BearXP/ESP32_WiFi/PowerSupplyDesign/Calcs/Transformerless_HalfWaverRectifier.xlsx

Design |  | Power | Minimum possible Iin - For application
Vrms | 115 |  | VHRMS | 75.23174593
Vzener | 5.1 | 0.217W |  |  | VRms | 110
f | 60 |  |  |  | Vz | 5.1
C | 4.7e-07 | Use X2class | Xc1 | 7114.023918
R1 | 470 | 0.23W |  |  | C1 | 3.76e-07
 |  | 0.47W |  |  | f | 59.5
Vdiode | 0.6 |  | R1 | 517
 |  |  | Iin | 0.009858669916 | 0.009858669916
Vout | 4.5 |  | Iout | 0.009858669916
 |  |  | Maximum possible Iin - Power requirements for parts
 |  |  | VHRMS | 82.35281374
 |  |  |  |  | VRms | 120
 |  |  |  |  | Vz | 5
 |  |  | Xc1 | 4695.334699
 |  |  |  |  | C1 | 5.64e-07
 |  |  |  |  | f | 60.1
 |  |  | R1 | 423
 |  |  | Iin | 0.0160897672 | 0.0160897672
 |  |  | Iout | <=0.01609
http://ww1.microchip.com/downloads/en/AppNotes/00954A.pdf
