BearXP/ESP32_WiFi/BOM.xlsx

CapBridge7803_240V
ID | Ref | Description | Qty | Cost/ea | MOQ | Cost total | Link
1 | C1, C3 | CAP 1u X2 | 2 | $0.28 | 10 | $0.57 | 1uF (https://www.aliexpress.com/item/F011-1-1uF-10pcs-capacitor-X2-capacitor-275VAC-Pitch-22mm-X2-Polypropylene-film-capacitor-1uF/32714339342.html)
2 | D1,D2,D3,D4 | Bridge rectifier | 1 | $0.06 | 10 |  | Bridge (https://www.aliexpress.com/item/20pcs-MB10F-MB10-SOP4-1A-1000V-SMD-ultra-thin-bridge-rectifier-bridge-pile-high-quality/32553323900.html)
2.1 | D1,D2,D3,D4 | Bridge rectifier | 1 | $0.03 | 100 | $0.03 | 100 Bridge (https://www.aliexpress.com/item/100pcs-MB10F-MB10-SOP4-1A-1000V-SMD-ultra-thin-bridge-rectifier-bridge-pile-high-quality/32553068350.html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)
3 | D5 | Zener 6V2 1W | 1 | $0.05 | 50 | $0.05 | Zener (https://www.aliexpress.com/item/Free-shipping-10pcs-ZM4735A-1W-6-2V-LL41-6V2-Zener-diode/32379898135.html)
4 | C2, C4 | Cap 470u 16V | 2 | $0.05 | 20 | $0.11 | 470u (https://www.aliexpress.com/item/1LOT-20PCS-Aluminum-Capacitors-470uF-477-20-8-14mm-25V-470000nF-470000000pF-Diameter8mm/32709807005.html)
5 | U1 | Reg 3v3 | 1 | $0.03 | 100 | $0.03 | 3V3 (https://www.aliexpress.com/item/Free-Shipping-100PCS-LOT-Original-AMS1117-3-3-AMS1117-3-3V-AMS1117-LM1117-1117-Voltage-Regulator/32517690677.html)
6 | F1 | Polyfuse 0.5A 1206 | 1 | $0.05 | 50 |  | Polyfuse (https://www.aliexpress.com/item/50PCS-1206-0-5A-0-5-Amp-500mA-PolySwitch-SMT-SMD-Resettable-Fuse/32705064645.html)
6 | F1 | Fuse 0.5A 1206 | 1 | $0.04 | 50 | $0.04 | Fuse (https://www.aliexpress.com/item/50PCS-Lot-1206-0-5A-2A-0-1A-0-2A-0-5A-0-75A-1-1A/32812178091.html)
7 | V1 | Varistor | 1 | $0.07 | 100 | $0.07 | Varistor (https://www.aliexpress.com/item/50pcs-lot-Varistor-Resistor-Voltage-Dependent-Resistor-14D561K-14D-561K/32460788025.html)
8 | R3 | Res 47R | 1 | $0.01 | 100 | $0.01 | 47R (https://www.aliexpress.com/item/Free-shipping-50pcs-1-ohm-1-2W-Metal-film-resistor/32328677208.html)
 |  |  |  |  |  | $0.91
Integrated Rectifier - Replaces Diodes - Fixed 5V out
ID | Ref | Description | Qty | Cost/ea | MOQ | Cost total | Link
1 | U1 | Rectifier 5V 2W | 1 | 3.275 | 10 | 3.275 | Rectifier (https://www.aliexpress.com/item/1pcs-2016-new-small-size-ac-dc-power-supply-220v-to-5v-2w-intelligent-household-isolated/32709066044.html)
2 | F1 | Fuse 0.5A 1206 | 1 | $0.04 | 50 | $0.04 | Fuse (https://www.aliexpress.com/item/50PCS-Lot-1206-0-5A-2A-0-1A-0-2A-0-5A-0-75A-1-1A/32812178091.html)
3 | V1 | Varistor | 1 | $0.07 | 100 | $0.07 | Varistor (https://www.aliexpress.com/item/50pcs-lot-Varistor-Resistor-Voltage-Dependent-Resistor-14D561K-14D-561K/32460788025.html)
4 | C2, C4 | Cap 470u 16V | 2 | $0.05 | 20 | $0.11 | 470U (https://www.aliexpress.com/item/1LOT-20PCS-Aluminum-Capacitors-470uF-477-20-8-14mm-25V-470000nF-470000000pF-Diameter8mm/32709807005.html)
5 | D5 | Zener 6V2 1W | 1 | $0.05 | 50 | $0.05 | Zener (https://www.aliexpress.com/item/Free-shipping-10pcs-ZM4735A-1W-6-2V-LL41-6V2-Zener-diode/32379898135.html)
6 | C1, C3 | CAP 1u X2 | 2 | $0.28 | 10 | $0.57 | 1uF (https://www.aliexpress.com/item/F011-1-1uF-10pcs-capacitor-X2-capacitor-275VAC-Pitch-22mm-X2-Polypropylene-film-capacitor-1uF/32714339342.html)
 |  |  |  |  |  | $4.11
Transformer - Replaces C1, C3, R1, & R3
ID | Ref | Description | Qty | Cost/ea | MOQ | Cost total | Link
1 | U1 | Transformer 12V 5W | 1 | 23.46 | 1 |  | Transformer (https://www.aliexpress.com/item/5W-double-12V-5W2-12V-transformer-power-transformer-Input-220V-50Hz-Output-Double-12v/32356521490.html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)
1.1 | Ua | Transformer 6V 5VA | 1 | $6.84 | 1 | 6.84 | RS Transformer (http://au.rs-online.com/web/p/pcb-transformers/1739923/)
2 | D1,D2,D3,D4 | Bridge rectifier | 1 | $0.06 | 10 |  | Bridge (https://www.aliexpress.com/item/20pcs-MB10F-MB10-SOP4-1A-1000V-SMD-ultra-thin-bridge-rectifier-bridge-pile-high-quality/32553323900.html)
2.1 | D1,D2,D3,D4 | Bridge rectifier | 1 | $0.03 | 100 | $0.03 | 100 Bridge (https://www.aliexpress.com/item/100pcs-MB10F-MB10-SOP4-1A-1000V-SMD-ultra-thin-bridge-rectifier-bridge-pile-high-quality/32553068350.html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)
3 | D5 | Zener 6V2 1W | 1 | $0.05 | 50 | $0.05 | Zener (https://www.aliexpress.com/item/Free-shipping-10pcs-ZM4735A-1W-6-2V-LL41-6V2-Zener-diode/32379898135.html)
4 | C2, C4 | Cap 470u 16V | 2 | $0.05 | 20 | $0.11 | 470U (https://www.aliexpress.com/item/1LOT-20PCS-Aluminum-Capacitors-470uF-477-20-8-14mm-25V-470000nF-470000000pF-Diameter8mm/32709807005.html)
5 | U1 | Reg 3v3 | 1 | $0.03 | 100 | $0.03 | 3V3 (https://www.aliexpress.com/item/Free-Shipping-100PCS-LOT-Original-AMS1117-3-3-AMS1117-3-3V-AMS1117-LM1117-1117-Voltage-Regulator/32517690677.html)
6 | F1 | Polyfuse 0.5A 1206 | 1 | $0.05 | 50 |  | Polyfuse (https://www.aliexpress.com/item/50PCS-1206-0-5A-0-5-Amp-500mA-PolySwitch-SMT-SMD-Resettable-Fuse/32705064645.html)
6 | F1 | Fuse 0.5A 1206 | 1 | $0.04 | 50 | $0.04 | Fuse (https://www.aliexpress.com/item/50PCS-Lot-1206-0-5A-2A-0-1A-0-2A-0-5A-0-75A-1-1A/32812178091.html)
7 | V1 | Varistor | 1 | $0.07 | 100 | $0.07 | Varistor (https://www.aliexpress.com/item/50pcs-lot-Varistor-Resistor-Voltage-Dependent-Resistor-14D561K-14D-561K/32460788025.html)
 |  |  |  |  |  | $7.17
