BearXP/ESP32_WiFi/PowerSupplyDesign/LTSpice/BridgeNPN_NMOS_7805.asc

C1: cap; 22p
C2: cap; 470µF; V=16V
C3: cap; 470µF; V=16V
D1: diode; RRE02VS6S
D2: diode; RRE02VS6S
D3: diode; RRE02VS6S
D4: diode; RRE02VS6S
D5: diode
M1: nmos
Q1: npn
R1: res; 4.7
R2: res; 220K; pwr=1
R3: res; 10K
R4: res; 47k; pwr=0.5W
R5: res; 1k
U1: LT1083-5
V1: voltage; SINE(0 338.4 50)
Named nets: 0
.tran 10s
