BearXP/ESP32_WiFi/PowerSupplyDesign/LTSpice/CapBridge7813.asc

C1: cap; 1µ; V=600V
C2: cap; 470µ; V=16V
C3: cap; 1µ; V=600V
C4: cap; 470µ; V=16V
D1: diode; RR2L6S
D2: diode; RR2L6S
D3: diode; RR2L6S
D4: diode; RR2L6S
D5: zener; BZX84C6V2L
R1: res; 470k; pwr=1
R2: res; 33R
R3: res; 47R
U1: LT1084-3.3
V1: voltage; SINE(0 340 50)
Named nets: 0
.tran 0.2s
