BearXP/ESP32_WiFi/PowerSupplyDesign/LTSpice/Draft1.asc

C1: cap; 2µ2; V=400
C2: cap; 470µ; V=16
D1: diode
D2: diode
D3: diode
D4: diode
D5: zener; BZX84C15L
D6: LED
R1: res; 470k; pwr=1
R2: res; 100R; pwr=1
R3: res; 220R; pwr=1
R4: res; 1k
V1: voltage; SINE(0 230 50)
Named nets: 0
.tran 0.5s
