BearXP/ESP32_WiFi/PowerSupplyDesign/LTSpice/Draft4.asc

C1: cap; 470µ
C2: cap; 470µ
C3: cap; 200p
D1: zener; BZX84C6V2L
D2: diode
M1: nmos; R6020PNJ
M2: nmos; R6020PNJ
R1: res; 10k
R2: res; 10k
R3: res; 50R
R4: res; 330k
V1: voltage; SINE(0 310 50)
Named nets: 0
.tran 100m
