BearXP/ESP32_WiFi/LightSwitch.brd

## EAGLE design LightSwitch.brd (2017-09-10)

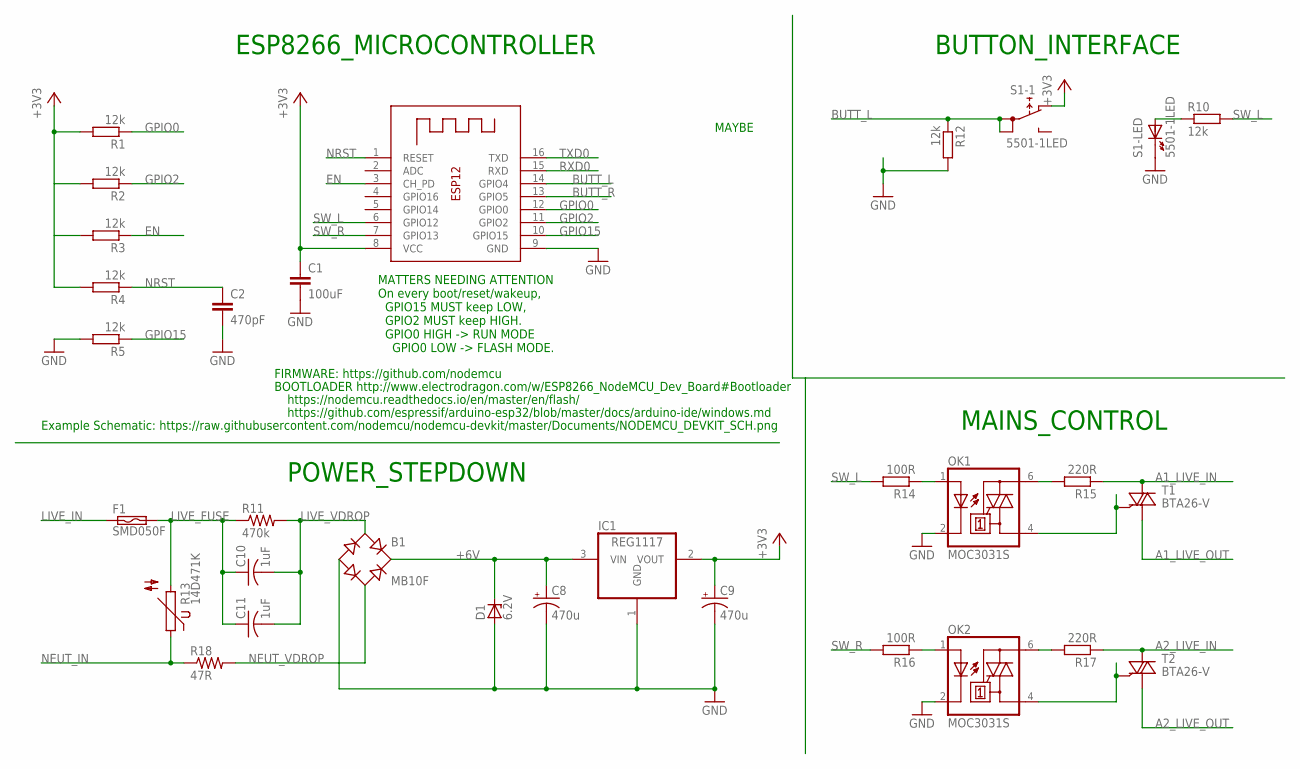
[picture p1: schematic LightSwitch.sch]

Parts:
B1: MB10F; SOIC-4
C1: 100uF; C0805K
C2: 470pF; C0805K
C8, C9: 470u; E3,5-8
C10, C11: 1uF; C225-074X268
D1: 6.2V; SMB
F1: SMD050F
IC1: REG1117; SOT223
OK1, OK2: MOC3031S; DIL6-SMD
R1, R2, R3, R4, R5, R10, R12: 12k; M0805
R11: 470k; 0309/12
R13: 14D471K; S07K40
R14, R16: 100R; M0805
R15, R17: 220R; M0805
R18: 47R; 0309/12
S1: 5501-1LED
T1, T2: BTA26-V; TOP3S-1
X1: ESP-12

Connections:
+3V1: R2.2
+3V2: R3.2
+3V3: C1.1, C9.+, IC1.2 (VOUT), R1.2, R4.2, S1.NC, X1.8 (VCC)
+6V: B1.+, C8.+, D1.C, IC1.3 (VIN)
A1_LIVE_IN: R15.1, T1.A2
A1_LIVE_OUT: T1.A1
A2_LIVE_IN: R17.1, T2.A2
A2_LIVE_OUT: T2.A1
BUTT_L: R12.1, S1.1A, S1.1B, X1.14 (GPIO4)
BUTT_R: X1.13 (GPIO5)
EN: R3.1, X1.3 (CH_PD)
GND: B1.-, C1.2, C2.2, C8.-, C9.-, D1.A, IC1.1 (GND), OK1.2 (C), OK2.2 (C), R5.2, R12.2, S1.- (K), X1.9 (GND)
GPIO0: R1.1, X1.12 (GPIO0)
GPIO2: R2.1, X1.11 (GPIO2)
GPIO15: R5.1, X1.10 (GPIO15)
LIVE_FUSE: C10.1, C11.1, F1.2, R11.1, R13.2
LIVE_IN: F1.1
LIVE_VDROP: B1.~1 (AC1), C10.2, C11.2, R11.2
unnamed: R10.1, S1.+ (A)
unnamed: OK1.1 (A), R14.1
unnamed: OK1.6 (A2), R15.2
unnamed: OK1.4 (A1), T1.G
unnamed: OK2.1 (A), R16.1
unnamed: OK2.6 (A2), R17.2
unnamed: OK2.4 (A1), T2.G
NEUT_IN: R13.1, R18.1
NEUT_VDROP: B1.~2 (AC2), R18.2
NRST: C2.1, R4.1, X1.1 (RESET)
RXD0: X1.15 (RXD)
SW_L: R10.2, R14.2, X1.6 (GPIO12)
SW_R: R16.2, X1.7 (GPIO13)
TXD0: X1.16 (TXD)

Notes on the sheet:
MATTERS NEEDING ATTENTION On every boot/reset/wakeup, GPIO15 MUST keep LOW, GPIO2 MUST keep HIGH. GPIO0 HIGH -> RUN MODE GPIO0 LOW -> FLASH MODE.
MAYBE
FIRMWARE: https://github.com/nodemcu
Example Schematic: https://raw.githubusercontent.com/nodemcu/nodemcu-devkit/master/Documents/NODEMCU_DEVKIT_SCH.png
BOOTLOADER http://www.electrodragon.com/w/ESP8266_NodeMCU_Dev_Board#Bootloader
https://nodemcu.readthedocs.io/en/master/en/flash/
https://github.com/espressif/arduino-esp32/blob/master/docs/arduino-ide/windows.md
MAINS_CONTROL
BUTTON_INTERFACE
ESP8266_MICROCONTROLLER
POWER_STEPDOWN

Board: 2 copper layers, 30 parts (0 on the bottom side), 24 nets, no tracks yet.
